jan-pablo/garden_water_supply/garden_water_supply_closed.jpg

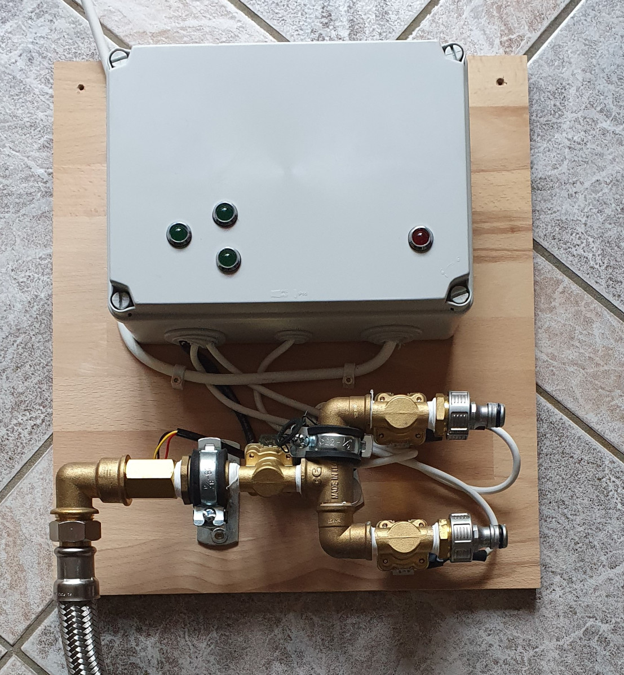
garden_water_supply_closed.jpg
