jan-pablo/garden_water_supply/garden_water_supply.png

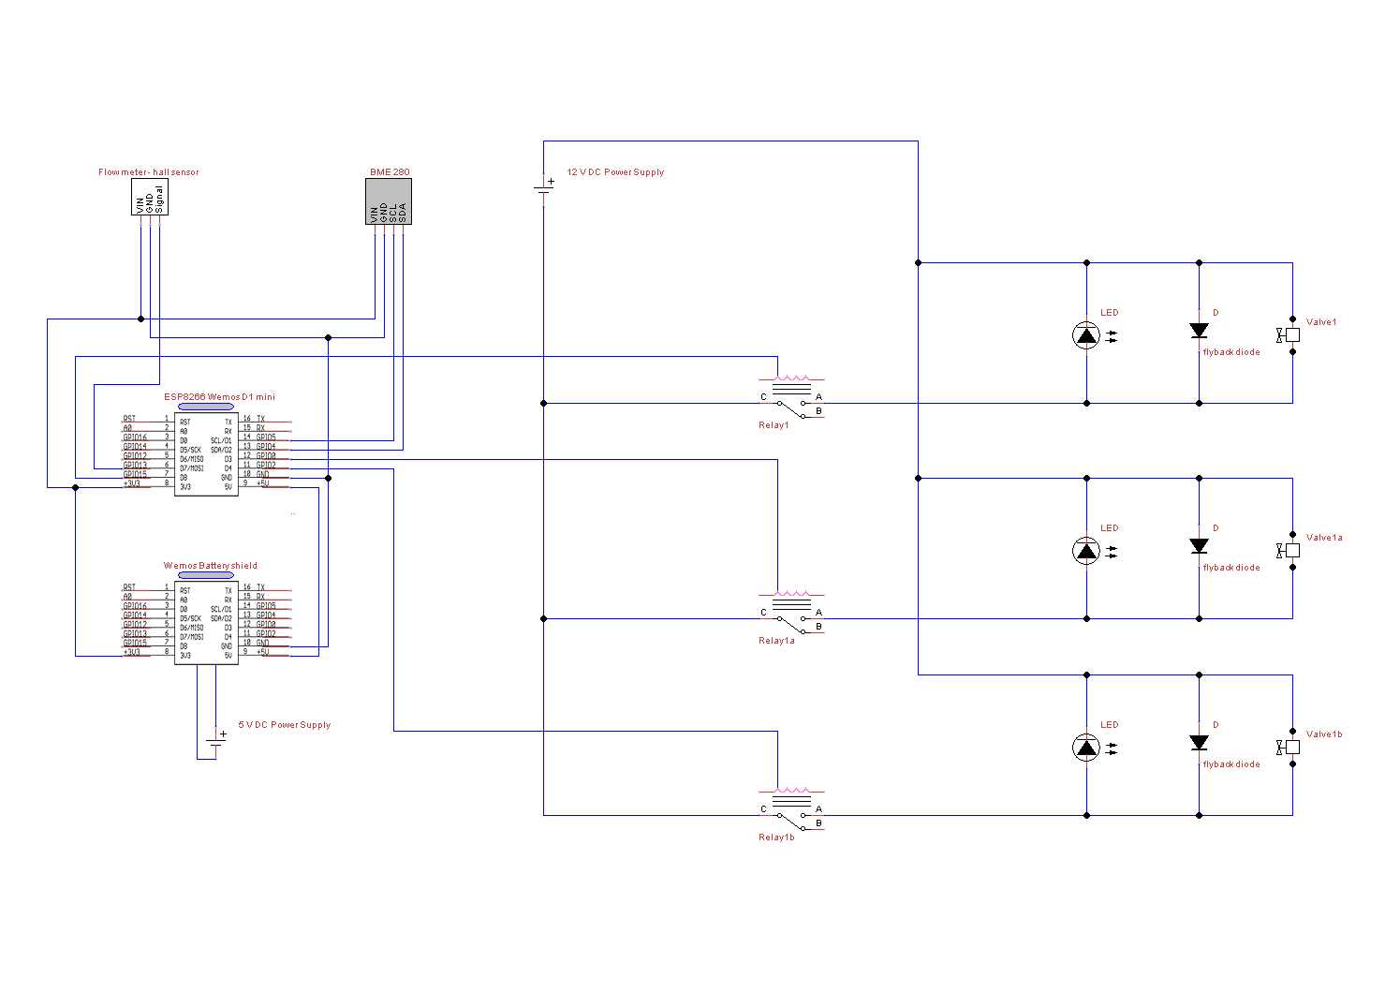
garden_water_supply.png
