jan-pablo/garden_water_supply/config.h.ino

//WLAN infos
const char* WLAN_host = "192.168.xyz.xyz";      // add IP of MQTT Server

// WiFi settings
const char* WIFI_ssid = "user_ssid";            // add your WLAN ssid
const char* WIFI_password = "user_password";    // add your WLAN password
