jan-pablo/garden_water_supply/(commit log)

2020-09-15 Excel File data transfer diagram
    Excel File with first draft of data transfer diagram uploaded
    [DataTransfer WEMOS MQTT FHEM TabletUI.xlsx]
2020-09-21 Arduino Program added
    Program for WEMOS D1 Mini added
2020-09-22 Added HTML for Tablet UI
    This HTML generates the GUI for commanding the irrigiation and visualising data like valve status, flow, temperature, humidity, timer status and so on.
2020-09-23 Added wiring
